aclandmark/Floating-point-display-for-UNO/FP_display_sys_diagram.bmp

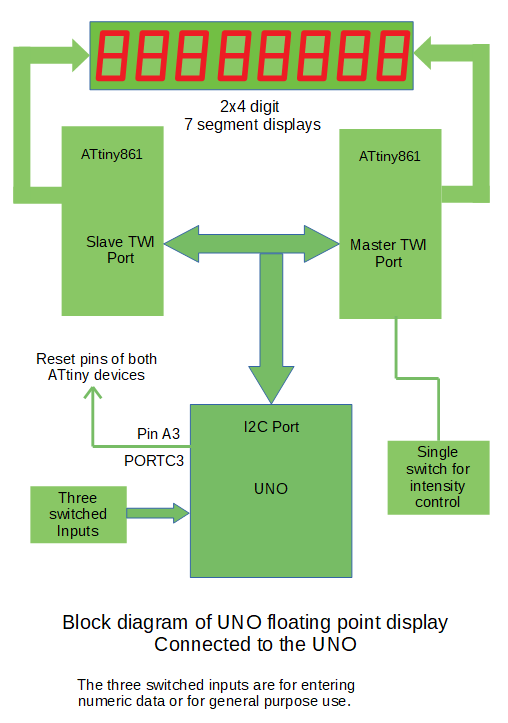
FP_display_sys_diagram.bmp
