aclandmark/Floating-point-display-for-UNO/Manufacturing drawings/Eagle files_FP_display_for_UNO/Eagle files/plug_in_A.brd

## EAGLE design Manufacturing drawings/Eagle files_FP_display_for_UNO/Eagle files/plug_in_A.brd (2022-12-22)

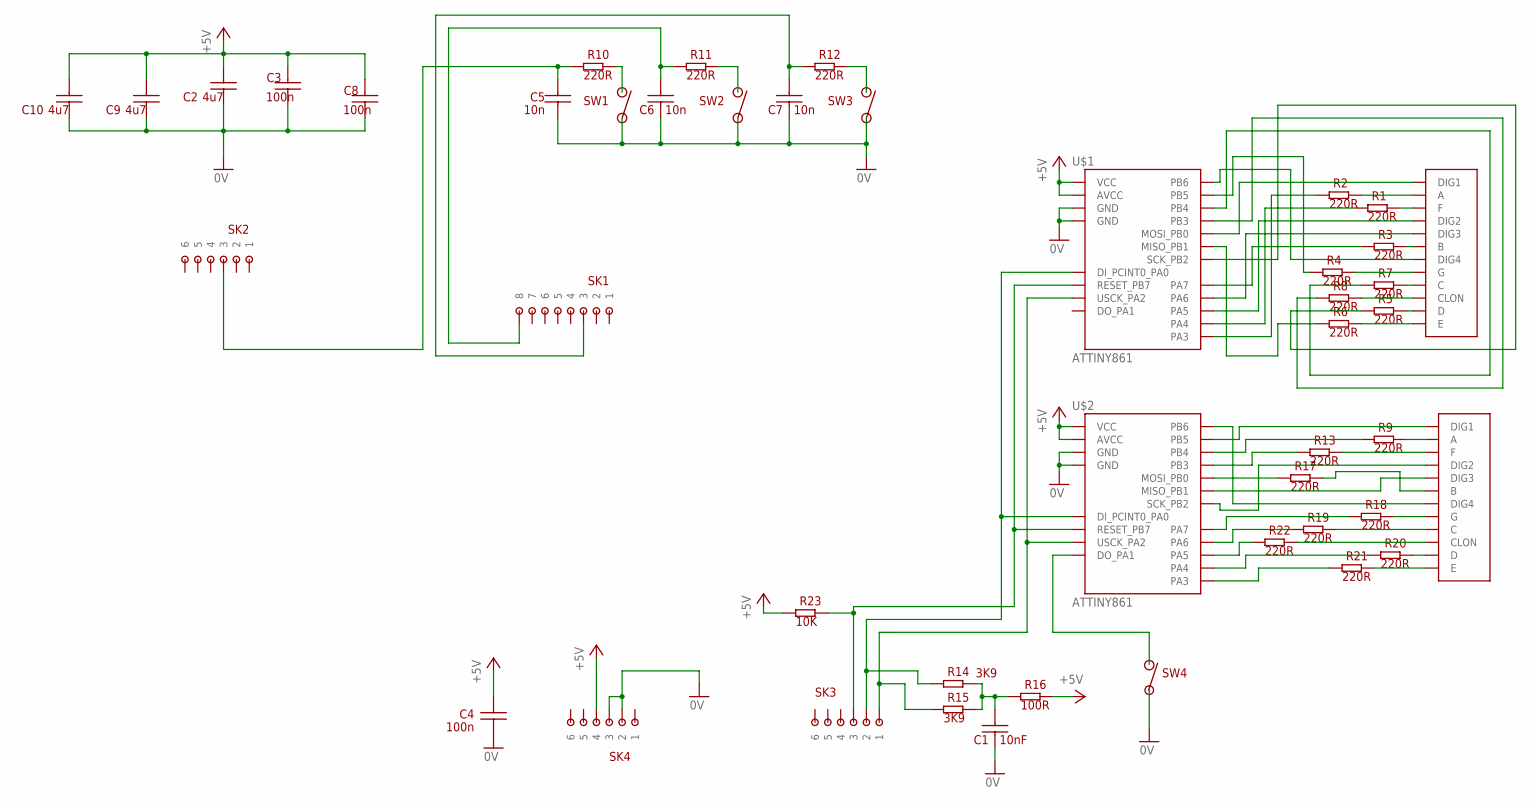
[picture p2: schematic plug_in_A.sch]

Parts:
C1: 10nF; 1206
C2, C9, C10: 4u7; 1206
C3, C4, C8: 100n; 1206
C5, C6, C7: 10n; 1206
R1, R2, R3, R4, R5, R6, R7, R8, R9, R10, R11, R12, R13, R17, R18, R19, R20, R21, R22: 220R; 1206
R14, R15: 3K9; 1206
R16: 100R; 1206
R23: 10K; 1206
SK1: 8_WAY_HEADER
SK2, SK3, SK4: 6_WAY_HEADER
SW1, SW2, SW3: BP_TH_NO; PB_NO_TH
SW4: PUSH_BUTTON_NO_SM
U$1, U$2: ATTINY861; DIL20
U$3, U$4: DISPLAY

Connections:
0V: C1.P$1, C2.P$1, C3.P$1, C4.P$1, C5.P$1, C6.P$1, C7.P$1, C8.P$1, C9.P$1, C10.P$1, SK4.P$2 (2), SK4.P$3 (3), SW1.P$2, SW2.P$2, SW3.P$2, SW4.P$2, U$1.6 (GND), U$1.16 (GND), U$2.6 (GND), U$2.16 (GND)
+5V: C2.P$2, C3.P$2, C4.P$2, C8.P$2, C9.P$2, C10.P$2, R16.P$2 (2), R23.P$1 (1), SK4.P$4 (4), U$1.5 (VCC), U$1.15 (AVCC), U$2.5 (VCC), U$2.15 (AVCC)
unnamed: SW4.P$1, U$2.19 (DO_PA1)
unnamed: U$1.1 (MOSI_PB0), U$3.P$12 (DIG1)
unnamed: U$1.12 (PA6), U$3.P$8 (DIG3)
unnamed: U$1.13 (PA5), U$3.P$9 (DIG2)
unnamed: R2.P$1 (1), U$1.17 (PA3)
unnamed: R23.P$2 (2), SK3.P$3 (3), U$1.10 (RESET_PB7), U$2.10 (RESET_PB7)
unnamed: R20.P$1 (1), U$2.14 (PA4)
unnamed: R6.P$1 (1), U$1.2 (MISO_PB1)
unnamed: U$1.9 (PB6), U$3.P$6 (DIG4)
unnamed: R14.P$1 (1), SK3.P$2 (2), U$1.20 (DI_PCINT0_PA0), U$2.20 (DI_PCINT0_PA0)
unnamed: R15.P$1 (1), SK3.P$1 (1), U$1.18 (USCK_PA2), U$2.18 (USCK_PA2)
unnamed: R10.P$2 (2), SW1.P$1
unnamed: R11.P$2 (2), SW2.P$1
unnamed: R12.P$2 (2), SW3.P$1
unnamed: C7.P$2, R12.P$1 (1), SK1.P$3 (3)
unnamed: R4.P$1 (1), U$1.8 (PB5)
unnamed: C5.P$2, R10.P$1 (1), SK2.P$3 (3)
unnamed: C6.P$2, R11.P$1 (1), SK1.P$8 (8)
unnamed: C1.P$2, R14.P$2 (2), R15.P$2 (2), R16.P$1 (1)
unnamed: R8.P$1 (1), U$1.4 (PB3)
unnamed: R7.P$1 (1), U$1.7 (PB4)
unnamed: R5.P$1 (1), U$1.3 (SCK_PB2)
unnamed: R1.P$1 (1), U$1.14 (PA4)
unnamed: R3.P$1 (1), U$1.11 (PA7)
unnamed: U$2.9 (PB6), U$4.P$6 (DIG4)
unnamed: R4.P$2 (2), U$3.P$5 (G)
unnamed: R18.P$1 (1), U$2.11 (PA7)
unnamed: R19.P$1 (1), U$2.12 (PA6)
unnamed: R22.P$1 (1), U$2.13 (PA5)
unnamed: R2.P$2 (2), U$3.P$11 (A)
unnamed: R21.P$1 (1), U$2.17 (PA3)
unnamed: U$2.8 (PB5), U$4.P$12 (DIG1)
unnamed: R9.P$1 (1), U$2.7 (PB4)
unnamed: R13.P$1 (1), U$2.4 (PB3)
unnamed: U$2.3 (SCK_PB2), U$4.P$9 (DIG2)
unnamed: U$2.2 (MISO_PB1), U$4.P$8 (DIG3)
unnamed: R17.P$2 (2), U$4.P$7 (B)
unnamed: R3.P$2 (2), U$3.P$7 (B)
unnamed: R1.P$2 (2), U$3.P$10 (F)
unnamed: R7.P$2 (2), U$3.P$4 (C)
unnamed: R5.P$2 (2), U$3.P$2 (D)
unnamed: R6.P$2 (2), U$3.P$1 (E)
unnamed: R8.P$2 (2), U$3.P$3 (CLON)
unnamed: R17.P$1 (1), U$2.1 (MOSI_PB0)
unnamed: R9.P$2 (2), U$4.P$11 (A)
unnamed: R13.P$2 (2), U$4.P$10 (F)
unnamed: R18.P$2 (2), U$4.P$5 (G)
unnamed: R19.P$2 (2), U$4.P$4 (C)
unnamed: R20.P$2 (2), U$4.P$2 (D)
unnamed: R21.P$2 (2), U$4.P$1 (E)
unnamed: R22.P$2 (2), U$4.P$3 (CLON)

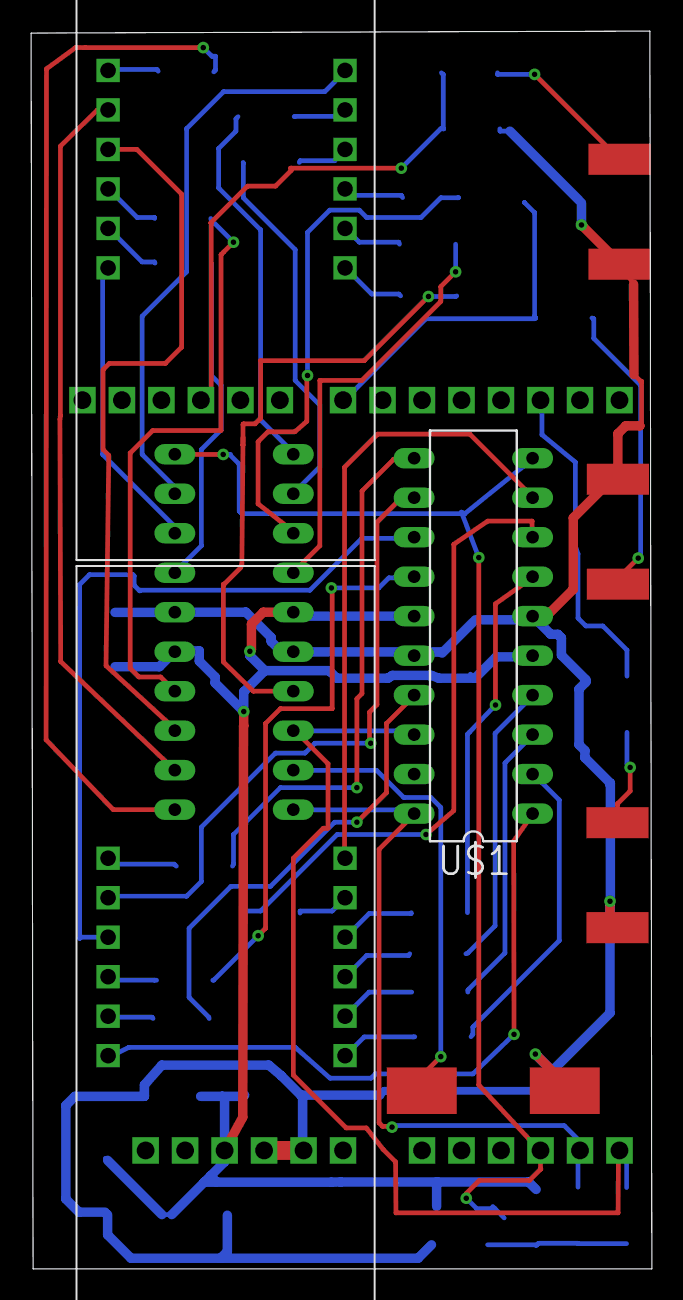
[picture p3: board plug_in_A.brd from above]

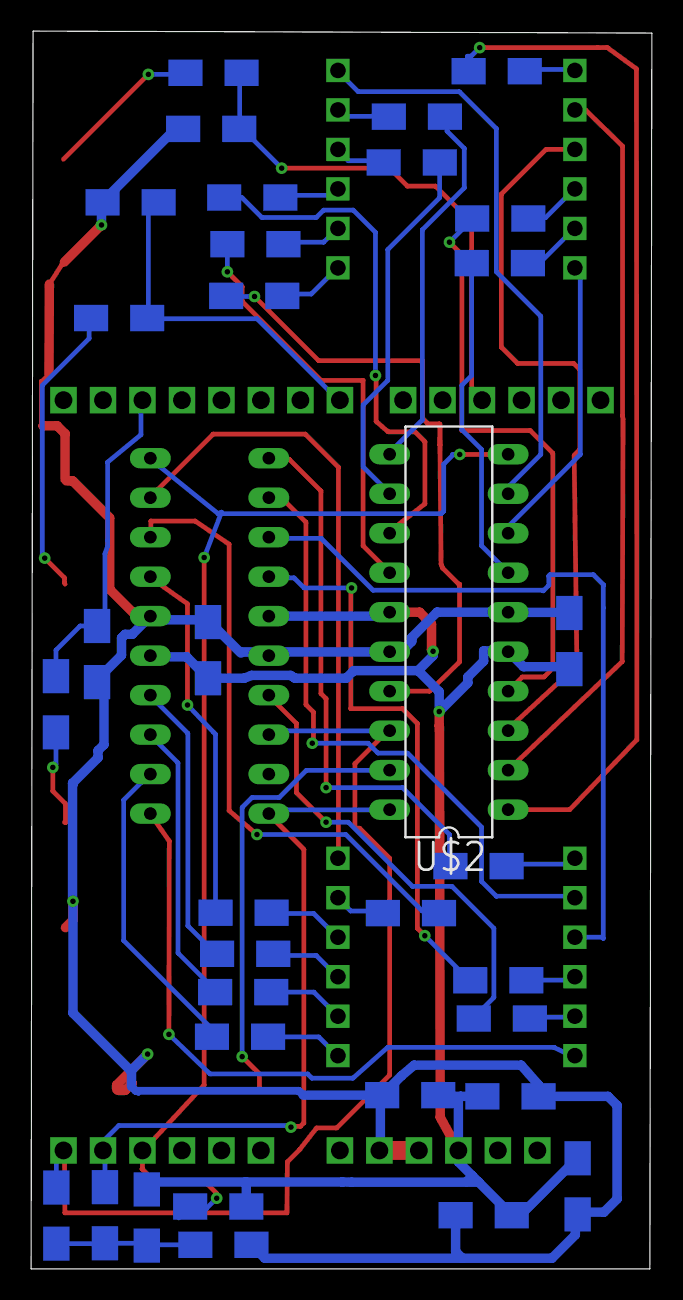
[picture p4: board plug_in_A.brd from below]

Board: 2 copper layers, 39.9 x 79.6 mm, 45 parts (34 on the bottom side), 53 nets.
